cosmic-pi-deprecated/uTelescope/README.md

# uTelescope
A new mini detector developed during the GTI SDG summer school 2017
