cosmic-pi-deprecated/uTelescope/CosmicPiuTelescopeSchematic.pdf

# LM358DR-SOIC8 22uf

## +5V+³V3

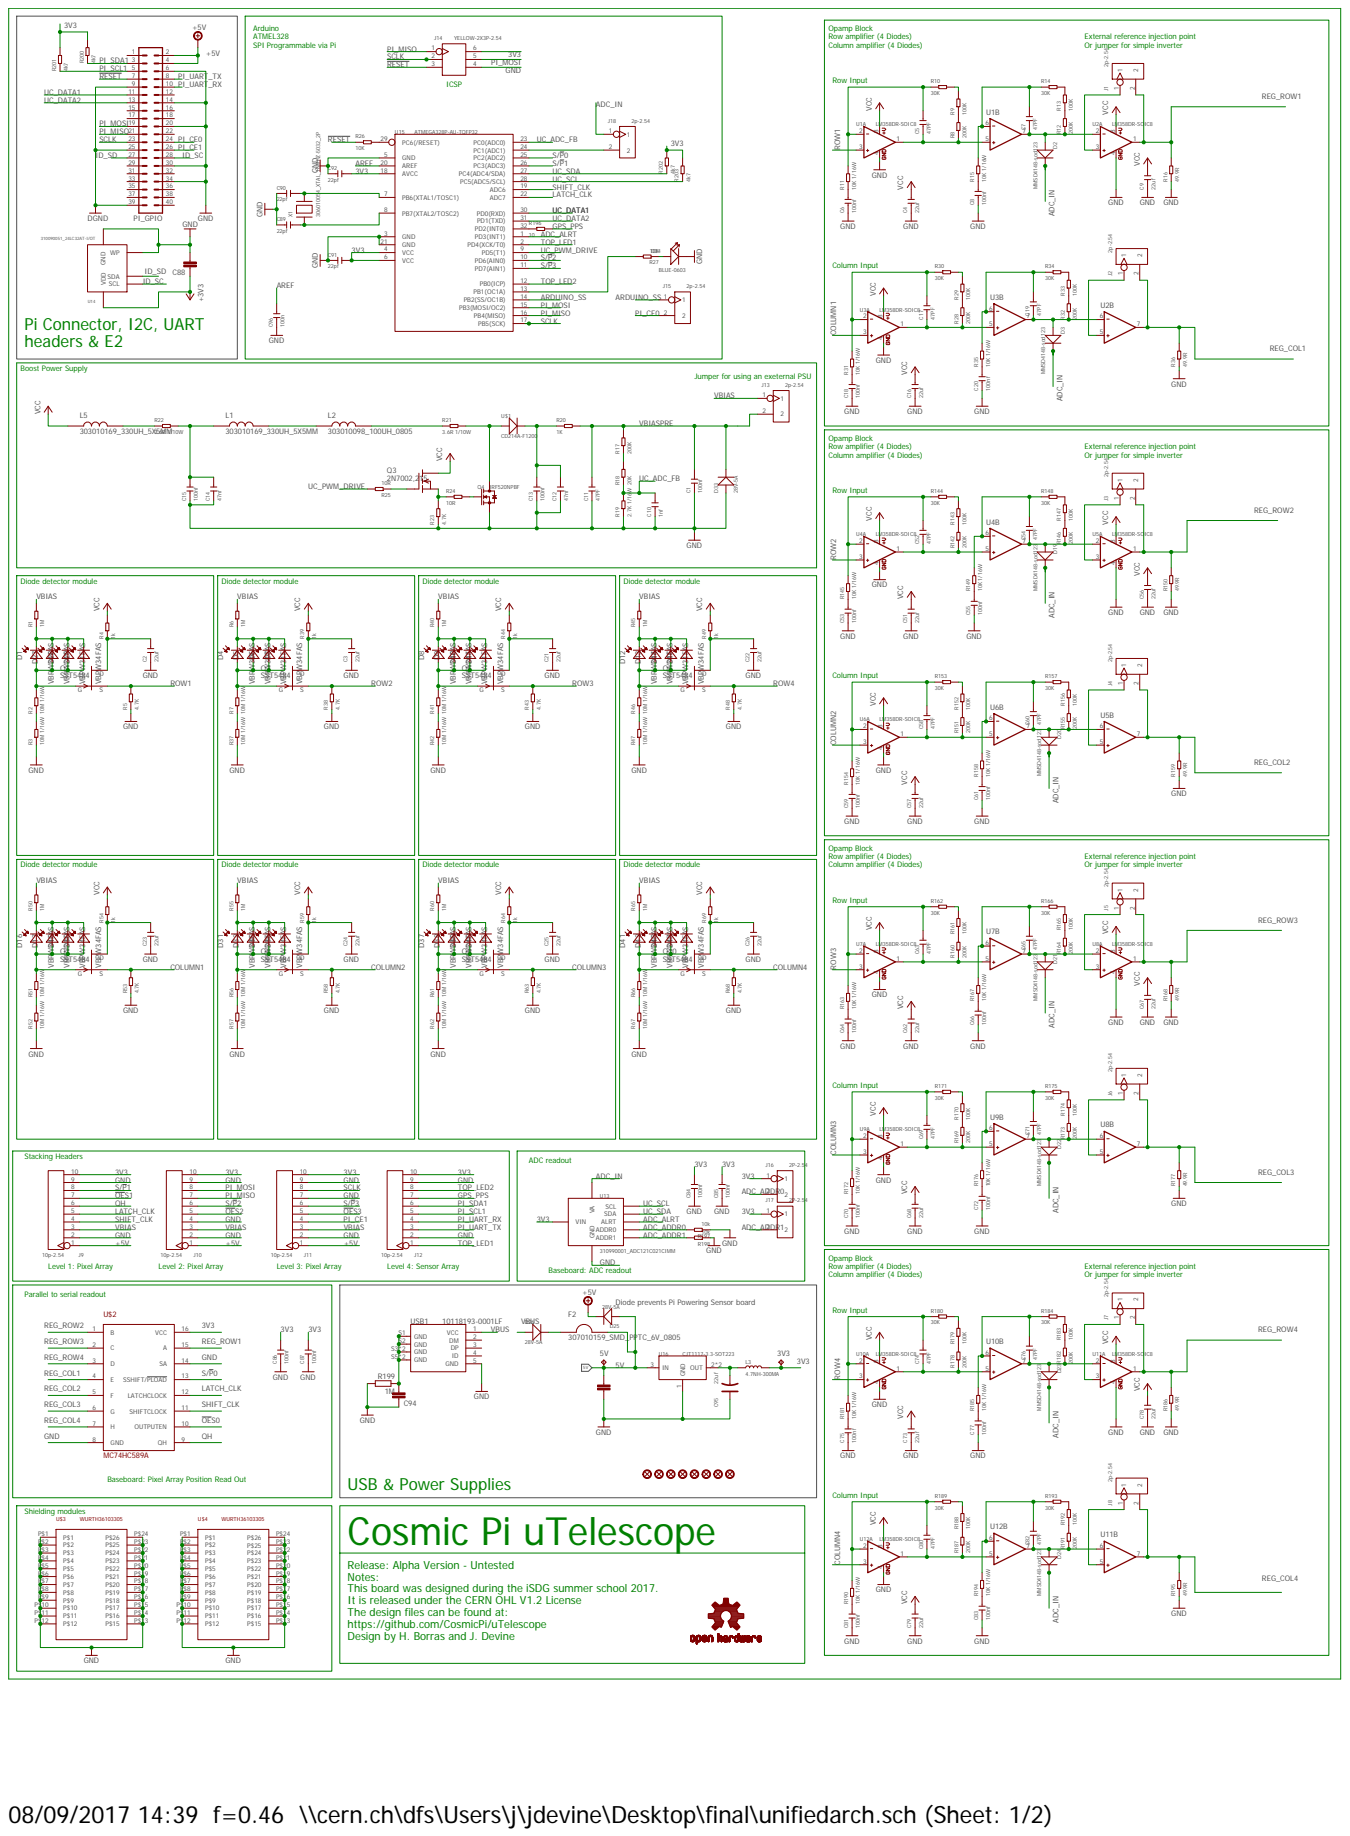
[picture p1: page 1]

External reference injection point
Or jumper for simple inverter

Jumper for using an exeternal PSU

Parallel to serial readout

Diode prevents Pi Powering Sensor board

Baseboard: Pixel Array Position Read Out

Release: Alpha Version - Untested
Notes:
This board was designed during the iSDG summer school 2017.
It is released under the CERN OHL V1.2 License
The design files can be found at:
https://github.com/CosmicPi/uTelescope
Design by H. Borras and J. Devine

08/09/2017 14:39 f=0.46 \\cern.ch\dfs\Users\j\jdevine\Desktop\final\unifiedarch.sch (Sheet: 1/2)
