cosmic-pi-deprecated/uTelescope/CosmicPiuTelescopeAlpha.brd

## EAGLE design CosmicPiuTelescopeAlpha.brd (2017-09-08)

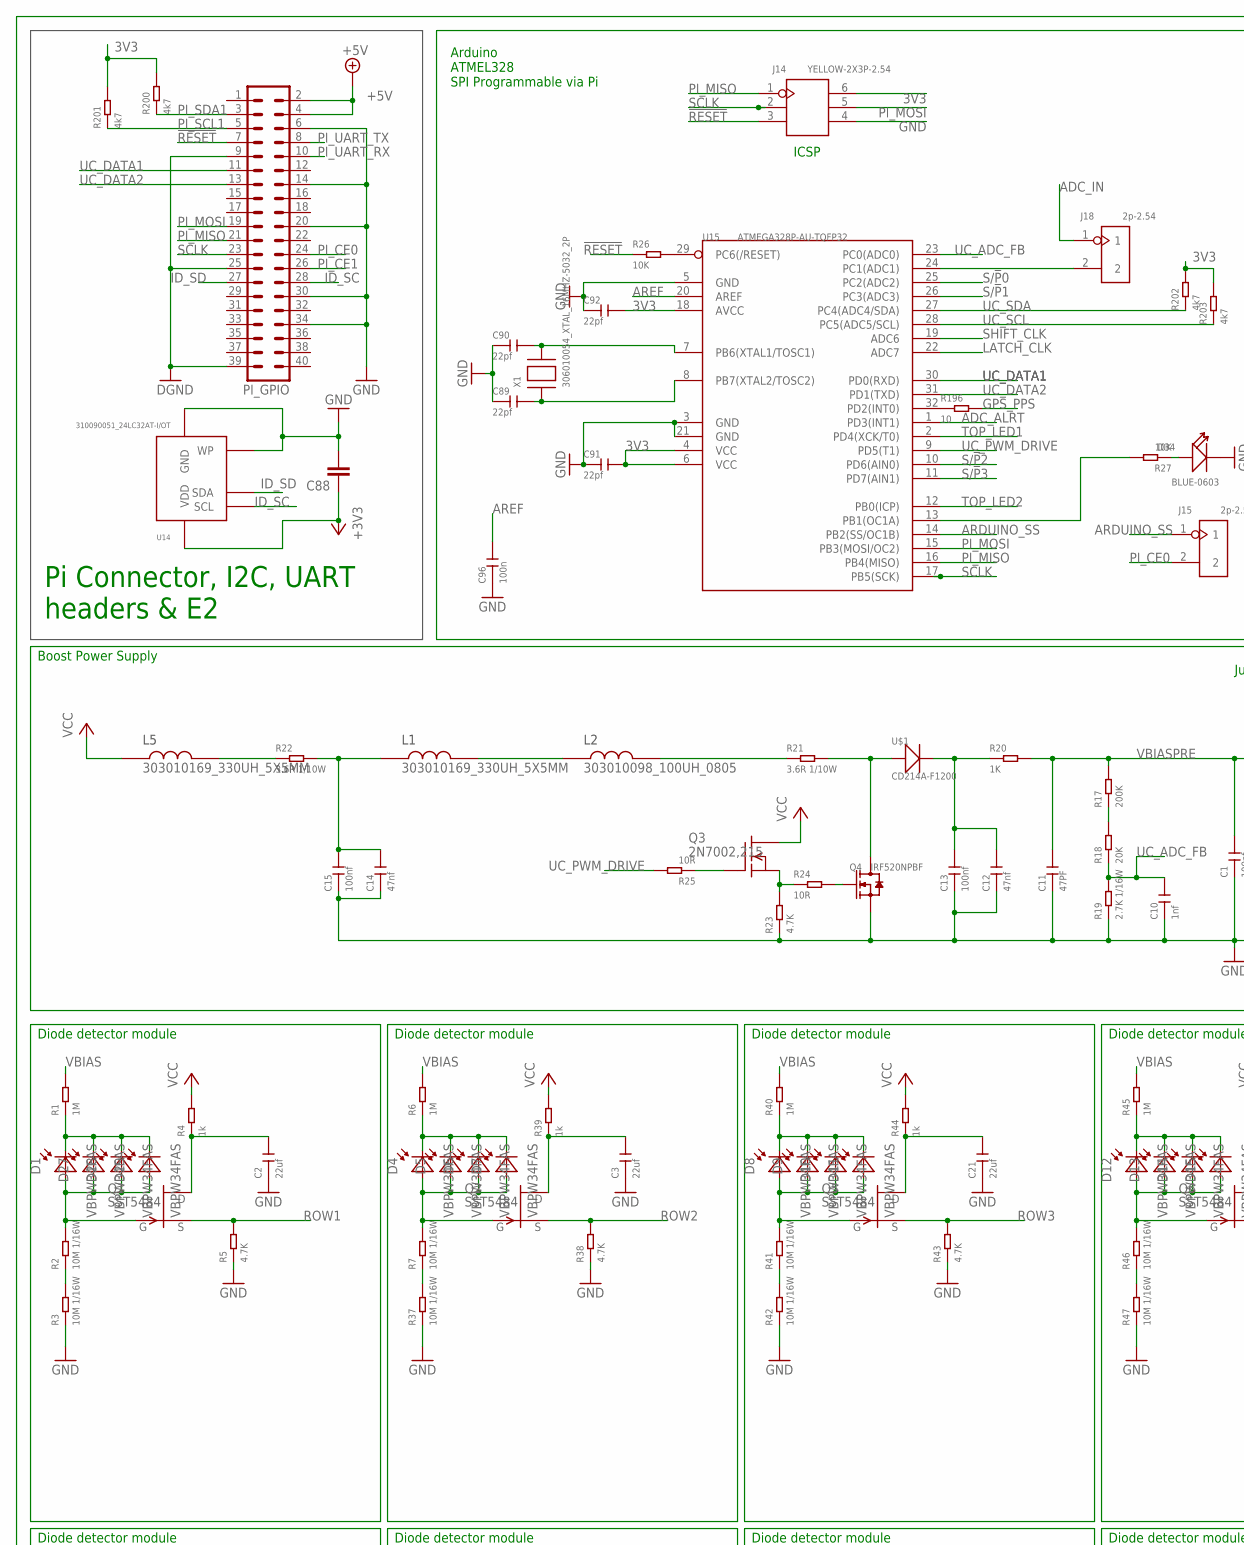
[picture p2: schematic CosmicPiuTelescopeAlpha.sch, sheet 1, part in row 1, column 1]

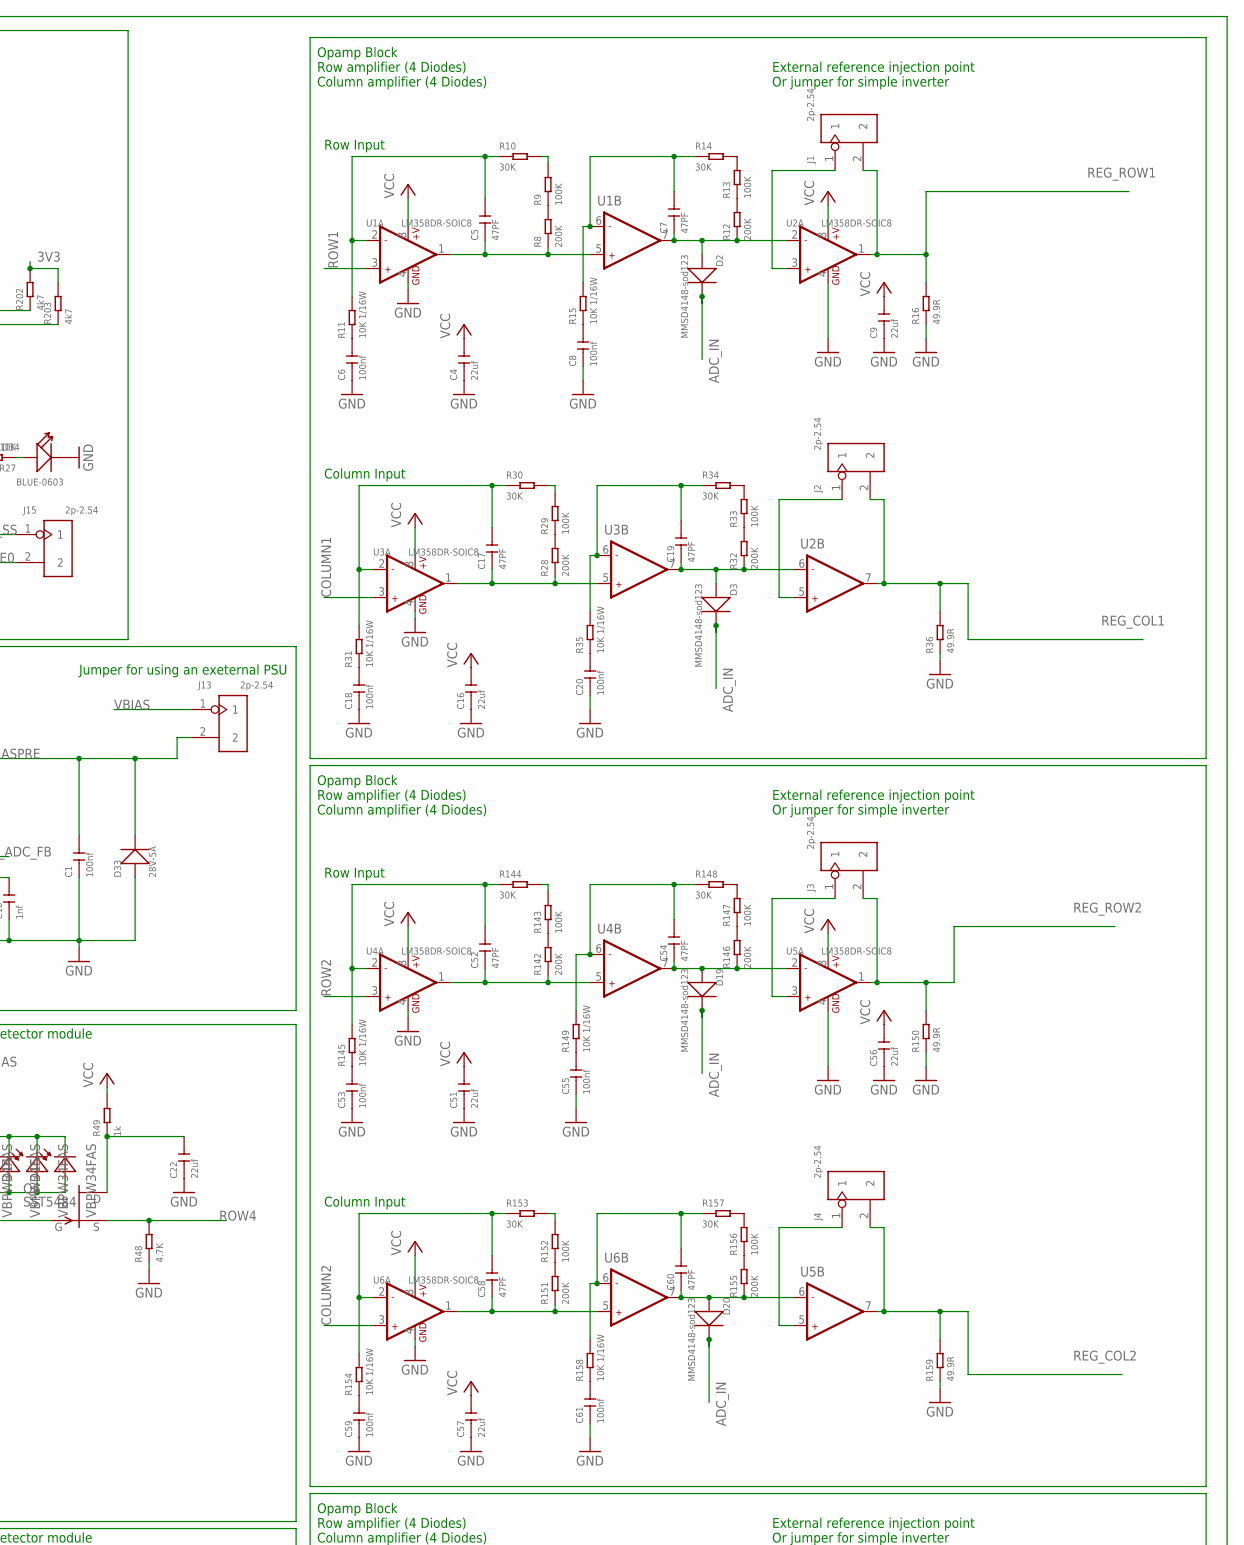
[picture p3: schematic CosmicPiuTelescopeAlpha.sch, sheet 1, part in row 1, column 2]

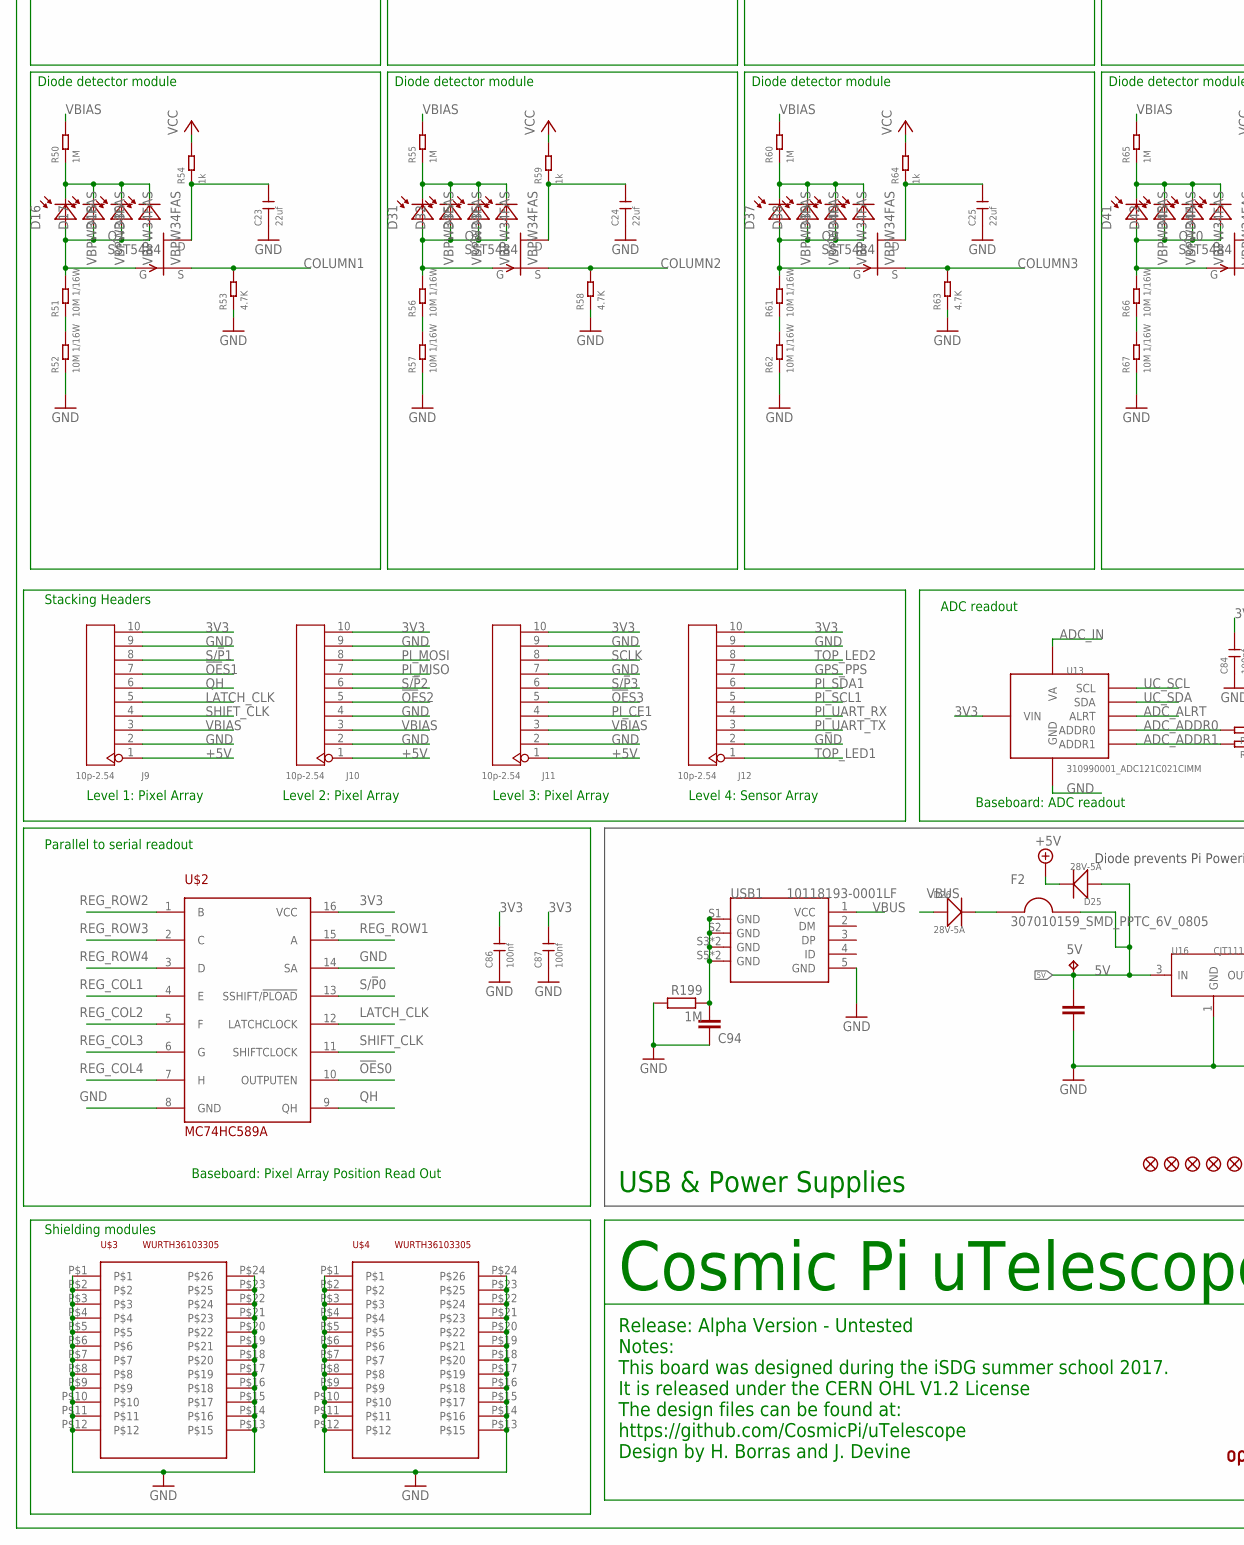
[picture p4: schematic CosmicPiuTelescopeAlpha.sch, sheet 1, part in row 2, column 1]

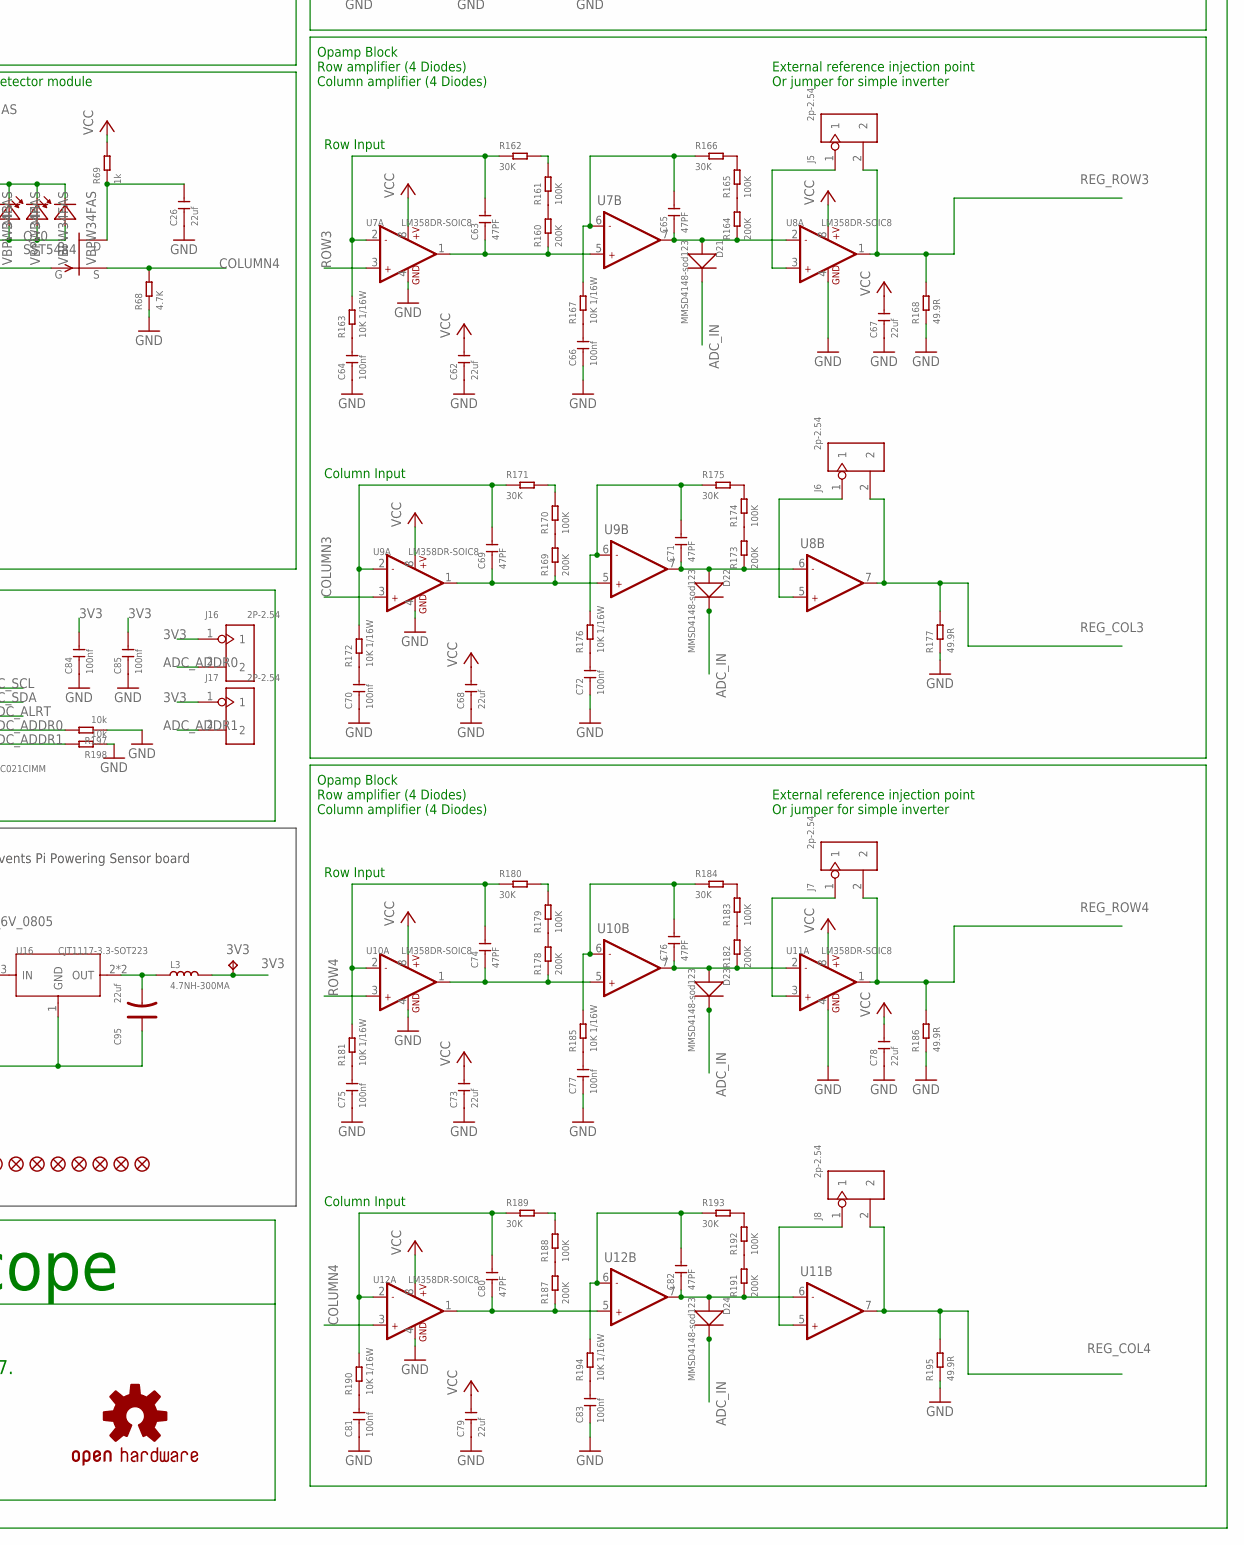
[picture p5: schematic CosmicPiuTelescopeAlpha.sch, sheet 1, part in row 2, column 2]

Parts:
3V3, 5V: TPB1,27; B1,27
C1, C13, C15: 100nf; C0603
C2, C3, C21, C22, C23, C24, C25, C26: 22uf; C1206
C4, C9, C16, C51, C56, C57, C62, C67, C68, C73, C78, C79: 22uf; C0805
C5, C7, C11, C17, C19, C52, C54, C58, C60, C63, C65, C69, C71, C74, C76, C80, C82: 47PF; C0402
C6, C8, C18, C20, C53, C55, C59, C61, C64, C66, C70, C72, C75, C77, C81, C83: 100nf; C0402
C10: 1nf; C0603
C12, C14: 47nf; C0402
C84, C85, C86, C87: 100nf; C1206
C88, C94: C-EUC0402; C0402
C89, C90, C91, C92: 22pf; C0603
C93: 47uF; 1206
C95: 22uf; AVX-B
C96: 100n; C0603
D1, D4, D5, D6, D7, D8, D9, D10, D11, D12, D13, D14, D15, D16, D17, D18, D27, D28, D29, D30, D31, D32, D35, D36, D37, D38, D39, D40, D41, D42, D43, D44: VBPW34FAS; SOD6439X130N
D2, D3, D19, D20, D21, D22, D23, D24: MMSD4148-sod123; SOD-123
D25, D26, D33: 28V-5A; DO-214AA
D34: BLUE-0603; LED-0603
F2: 307010159_SMD_PPTC_6V_0805; F0805
FD1, FD2, FD3, FD4, FD5, FD6, FD7, FD8: FIDUCIAL1X2; FIDUCIAL-1X2
J1, J2, J3, J4, J5, J6, J7, J8, J13, J15, J18: 2p-2.54; H2-2.54
J9, J10, J11, J12: 10p-2.54; H10-2.54
J14: YELLOW-2X3P-2.54; H2X3-2.54
J16, J17: 2P-2.54; H2-2.54
L1, L5: 303010169_330UH_5X5MM; L2018
L2: 303010098_100UH_0805; L0805
L3: 4.7NH-300MA; L0402
LOGO1: OSHW-LOGOL; OSHW-LOGO-L
PI_GPIO: MA20-2
Q1, Q2, Q5, Q6, Q7, Q8, Q9, Q10: SST5484; SOT23
Q3: 2N7002,215; SOT23
Q4: IRF520NPBF; TO-220
R1, R6, R40, R45, R50, R55, R60, R65, R199: 1M; R0402
R2, R3, R7, R37, R41, R42, R46, R47, R51, R52, R56, R57, R61, R62, R66, R67: 10M 1/16W; R0402
R4, R39, R44, R49, R54, R59, R64, R69: 1k; R0402
R5, R38, R43, R48, R53, R58, R63, R68: 4.7K; R0402
R8, R12, R17, R28, R32, R142, R146, R151, R155, R160, R164, R169, R173, R178, R182, R187, R191: 200K; R0603
R9, R13, R29, R33, R143, R147, R152, R156, R161, R165, R170, R174, R179, R183, R188, R192: 100K; R0402
R10, R14, R30, R34, R144, R148, R153, R157, R162, R166, R171, R175, R180, R184, R189, R193: 30K; R0603
R11, R15, R31, R35, R145, R149, R154, R158, R163, R167, R172, R176, R181, R185, R190, R194: 10K 1/16W; R0402
R16, R36, R150, R159, R168, R177, R186, R195: 49.9R; R0402
R18: 20K; R0603
R19: 2.7K 1/16W; R0402
R20: 1K; R0603
R21, R22: 3.6R 1/10W; R0603
R23: 4.7K; R0805
R24, R25: 10R; R0603
R26, R27: 10K; R0603
R196: 10; R0603
R197, R198: 10k; R0402
R200, R201, R202, R203: 4k7; R0603
U1, U2, U3, U4, U5, U6, U7, U8, U9, U10, U11, U12: LM358DR-SOIC8; SOIC8-1.27-5X4MM
U13: 310990001_ADC121C021CIMM; VSSOP8
U14: 310090051_24LC32AT-I/OT; SOT235
U15: ATMEGA328P-AU-TQFP32; TQFP32-0.8-7X7MM
U16: CJT1117-3.3-SOT223; SOT-223
U$1: CD214A-F1200; DIOM8059X265N
U$2: MC74HC589A; SOIC127P600X175-16N
U$3, U$4: WURTH36103305; 36103305
USB1: 10118193-0001LF; MICRO-USB5+6P-SMD-0.65-B
X1: 306010054_XTAL_16MHZ-5032_2P; X5032_2P

Connections:
3V3: 3V3.TP, C84.2, C85.2, C86.2, C87.2, C88.1, C91.2, C92.2, J9.10, J10.10, J11.10, J12.10, J14.6, J16.1, J17.1, L3.2, R200.2, R201.2, R202.2, R203.2, U13.P$4 (VIN), U14.4 (VDD), U15.4 (VCC), U15.6 (VCC), U15.18 (AVCC), U$2.16 (VCC)
5V: 5V.TP, C93.1, D25.+, F2.P$2, U16.3 (IN)
!OE!S0: U$2.10 (OUTPUTEN)
!OE!S1: J9.7
!OE!S2: J10.5
!OE!S3: J11.5
!RESET: J14.3, PI_GPIO.7, R26.1
+5V: C4.2, C9.2, C16.2, C51.2, C56.2, C57.2, C62.2, C67.2, C68.2, C73.2, C78.2, C79.2, D25.-, J9.1, J10.1, J11.1, L5.P$1, PI_GPIO.2, PI_GPIO.4, Q3.3 (D), R4.2, R39.2, R44.2, R49.2, R54.2, R59.2, R64.2, R69.2, U1.8 (+V), U2.8 (+V), U3.8 (+V), U4.8 (+V), U5.8 (+V), U6.8 (+V), U7.8 (+V), U8.8 (+V), U9.8 (+V), U10.8 (+V), U11.8 (+V), U12.8 (+V)
ADC_ADDR0: J16.2, R197.2, U13.P$3 (ADDR0)
ADC_ADDR1: J17.2, R198.2, U13.P$6 (ADDR1)
ADC_ALRT: U13.P$2 (ALRT), U15.1 (PD3(INT1))
ADC_IN: D2.-, D3.-, D19.-, D20.-, D21.-, D22.-, D23.-, D24.-, J18.1, U13.P$5 (VA)
ARDUINO_SS: J15.1, U15.14 (PB2(SS/OC1B))
AREF: C96.2, U15.20 (AREF)
COLUMN1: Q7.2 (S), R53.2, U3.3 (+IN1)
COLUMN2: Q8.2 (S), R58.2, U6.3 (+IN1)
COLUMN3: Q9.2 (S), R63.2, U9.3 (+IN1)
COLUMN4: Q10.2 (S), R68.2, U12.3 (+IN1)
GND: C1.1, C2.1, C3.1, C4.1, C6.1, C8.1, C9.1, C10.1, C11.1, C12.1, C13.1, C14.1, C15.1, C16.1, C18.1, C20.1, C21.1, C22.1, C23.1, C24.1, C25.1, C26.1, C51.1, C53.1, C55.1, C56.1, C57.1, C59.1, C61.1, C62.1, C64.1, C66.1, C67.1, C68.1, C70.1, C72.1, C73.1, C75.1, C77.1, C78.1, C79.1, C81.1, C83.1, C84.1, C85.1, C86.1, C87.1, C88.2, C89.1, C90.1, C91.1, C92.1, C93.2, C94.1, C95.+, C96.1, D33.+, D34.-, J9.2, J9.9, J10.2, J10.4, J10.9, J11.2, J11.7, J11.9, J12.2, J12.9, J14.4, PI_GPIO.6, PI_GPIO.9, PI_GPIO.14, PI_GPIO.20, PI_GPIO.25, PI_GPIO.30, PI_GPIO.34, PI_GPIO.39, Q4.2 (S), Q4.HEAT (S), R3.1, R5.1, R16.1, R19.1, R23.1, R36.1, R37.1, R38.1, R42.1, R43.1, R47.1, R48.1, R52.1, R53.1, R57.1, R58.1, R62.1, R63.1, R67.1, R68.1, R150.1, R159.1, R168.1, R177.1, R186.1, R195.1, R197.1, R198.1, R199.2, U1.4 (GND), U2.4 (GND), U3.4 (GND), U4.4 (GND), U5.4 (GND), U6.4 (GND), U7.4 (GND), U8.4 (GND), U9.4 (GND), U10.4 (GND), U11.4 (GND), U12.4 (GND), U13.P$7 (GND), U14.2 (GND), U14.5 (WP), U15.3 (GND), U15.5 (GND), U15.21 (GND), U16.1 (GND), U$2.8 (GND), U$2.14 (SA), U$3.P$1, U$3.P$2, U$3.P$3, U$3.P$4, U$3.P$5, U$3.P$6, U$3.P$7, U$3.P$8, U$3.P$9, U$3.P$10, U$3.P$11, U$3.P$12, U$3.P$13, U$3.P$14, U$3.P$15, U$3.P$16, U$3.P$17, U$3.P$18, U$3.P$19, U$3.P$20, U$3.P$21, U$3.P$22, U$3.P$23, U$3.P$24, U$4.P$1, U$4.P$2, U$4.P$3, U$4.P$4, U$4.P$5, U$4.P$6, U$4.P$7, U$4.P$8, U$4.P$9, U$4.P$10, U$4.P$11, U$4.P$12, U$4.P$13, U$4.P$14, U$4.P$15, U$4.P$16, U$4.P$17, U$4.P$18, U$4.P$19, U$4.P$20, U$4.P$21, U$4.P$22, U$4.P$23, U$4.P$24, USB1.5 (GND)
GPS_PPS: J12.7, R196.2
ID_SC: PI_GPIO.28, U14.1 (SCL)
ID_SD: PI_GPIO.27, U14.3 (SDA)
LATCH_CLK: J9.5, U15.22 (ADC7), U$2.12 (LATCHCLOCK)
unnamed: Q4.3 (D), R21.2, U$1.1 (+)
unnamed: D1.C, D27.C, D28.C, D29.C, R1.1
unnamed: D1.A, D27.A, D28.A, D29.A, Q1.3 (G), R2.2
unnamed: R2.1, R3.2
unnamed: C2.2, Q1.1 (D), R4.1
unnamed: R28.2, R29.1
unnamed: C18.2, R31.1
unnamed: D4.C, D5.C, D6.C, D7.C, R6.1
unnamed: R8.2, R9.1
unnamed: C6.2, R11.1
unnamed: C5.1, R8.1, U1.1 (OUT1), U1.5 (+IN2)
unnamed: R9.2, R10.2
unnamed: C5.2, R10.1, R11.2, U1.2 (-IN1)
unnamed: R12.2, R13.1
unnamed: C8.2, R15.1
unnamed: R13.2, R14.2
unnamed: C7.2, R14.1, R15.2, U1.6 (-IN2)
unnamed: D4.A, D5.A, D6.A, D7.A, Q2.3 (G), R7.2
unnamed: R7.1, R37.2
unnamed: C7.1, D2.+, R12.1, U1.7 (OUT2), U2.2 (-IN1)
unnamed: J1.1, U2.3 (+IN1)
unnamed: R17.1, R18.2
unnamed: C14.2, C15.2, L1.P$1, R22.2
unnamed: C12.2, C13.2, R20.1, U$1.2 (-)
unnamed: L5.P$2, R22.1
unnamed: L2.P$2, R21.1
unnamed: Q3.2 (S), R23.2, R24.1
unnamed: Q3.1 (G), R25.1
unnamed: L1.P$2, L2.P$1
unnamed: Q4.1 (G), R24.2
unnamed: C17.1, R28.1, U3.1 (OUT1), U3.5 (+IN2)
unnamed: R29.2, R30.2
unnamed: C17.2, R30.1, R31.2, U3.2 (-IN1)
unnamed: R32.2, R33.1
unnamed: C20.2, R35.1
unnamed: R33.2, R34.2
unnamed: C19.2, R34.1, R35.2, U3.6 (-IN2)
unnamed: C19.1, D3.+, R32.1, U2.6 (-IN2), U3.7 (OUT2)
unnamed: C3.2, Q2.1 (D), R39.1
unnamed: J2.1, U2.5 (+IN2)
unnamed: D8.C, D9.C, D10.C, D11.C, R40.1
unnamed: D8.A, D9.A, D10.A, D11.A, Q5.3 (G), R41.2
unnamed: R41.1, R42.2
unnamed: C21.2, Q5.1 (D), R44.1
unnamed: D12.C, D13.C, D14.C, D15.C, R45.1
unnamed: D12.A, D13.A, D14.A, D15.A, Q6.3 (G), R46.2
unnamed: R46.1, R47.2
unnamed: C22.2, Q6.1 (D), R49.1
unnamed: D16.C, D17.C, D18.C, D30.C, R50.1
unnamed: D16.A, D17.A, D18.A, D30.A, Q7.3 (G), R51.2
unnamed: R51.1, R52.2
unnamed: C23.2, Q7.1 (D), R54.1
unnamed: D31.C, D32.C, D35.C, D36.C, R55.1
unnamed: D31.A, D32.A, D35.A, D36.A, Q8.3 (G), R56.2
unnamed: R56.1, R57.2
unnamed: C24.2, Q8.1 (D), R59.1
unnamed: D37.C, D38.C, D39.C, D40.C, R60.1
unnamed: D37.A, D38.A, D39.A, D40.A, Q9.3 (G), R61.2
unnamed: R61.1, R62.2
unnamed: C25.2, Q9.1 (D), R64.1
unnamed: D41.C, D42.C, D43.C, D44.C, R65.1
unnamed: D41.A, D42.A, D43.A, D44.A, Q10.3 (G), R66.2
unnamed: R66.1, R67.2
unnamed: C26.2, Q10.1 (D), R69.1
unnamed: R142.2, R143.1
unnamed: C53.2, R145.1
unnamed: C52.1, R142.1, U4.1 (OUT1), U4.5 (+IN2)
unnamed: R143.2, R144.2
unnamed: C52.2, R144.1, R145.2, U4.2 (-IN1)
unnamed: R146.2, R147.1
unnamed: C55.2, R149.1
unnamed: R147.2, R148.2
unnamed: C54.2, R148.1, R149.2, U4.6 (-IN2)
unnamed: C54.1, D19.+, R146.1, U4.7 (OUT2), U5.2 (-IN1)
unnamed: J3.1, U5.3 (+IN1)
unnamed: R151.2, R152.1
unnamed: C59.2, R154.1
unnamed: C58.1, R151.1, U6.1 (OUT1), U6.5 (+IN2)
unnamed: R152.2, R153.2
unnamed: C58.2, R153.1, R154.2, U6.2 (-IN1)
unnamed: R155.2, R156.1
unnamed: C61.2, R158.1
unnamed: R156.2, R157.2
unnamed: C60.2, R157.1, R158.2, U6.6 (-IN2)
unnamed: C60.1, D20.+, R155.1, U5.6 (-IN2), U6.7 (OUT2)
unnamed: J4.1, U5.5 (+IN2)
unnamed: C94.2, R199.1, USB1.S1 (GND), USB1.S2 (GND), USB1.S3 (GND), USB1.S4 (GND), USB1.S5 (GND), USB1.S6 (GND)
unnamed: R160.2, R161.1
unnamed: C64.2, R163.1
unnamed: C63.1, R160.1, U7.1 (OUT1), U7.5 (+IN2)
unnamed: R161.2, R162.2
unnamed: C63.2, R162.1, R163.2, U7.2 (-IN1)
unnamed: R164.2, R165.1
unnamed: C66.2, R167.1
unnamed: R165.2, R166.2
unnamed: C65.2, R166.1, R167.2, U7.6 (-IN2)
unnamed: C65.1, D21.+, R164.1, U7.7 (OUT2), U8.2 (-IN1)
unnamed: D26.-, F2.P$1
unnamed: J5.1, U8.3 (+IN1)
unnamed: R169.2, R170.1
unnamed: C70.2, R172.1
unnamed: C69.1, R169.1, U9.1 (OUT1), U9.5 (+IN2)
unnamed: R170.2, R171.2
unnamed: C69.2, R171.1, R172.2, U9.2 (-IN1)
unnamed: R173.2, R174.1
unnamed: C72.2, R176.1
unnamed: R174.2, R175.2
unnamed: C71.2, R175.1, R176.2, U9.6 (-IN2)
unnamed: C71.1, D22.+, R173.1, U8.6 (-IN2), U9.7 (OUT2)
unnamed: J6.1, U8.5 (+IN2)
unnamed: C95.-, L3.1, U16.2 (OUT), U16.TER (OUT)
unnamed: R178.2, R179.1
unnamed: C75.2, R181.1
unnamed: C74.1, R178.1, U10.1 (OUT1), U10.5 (+IN2)
unnamed: R179.2, R180.2
unnamed: C74.2, R180.1, R181.2, U10.2 (-IN1)
unnamed: R182.2, R183.1
unnamed: C77.2, R185.1
unnamed: R183.2, R184.2
unnamed: C76.2, R184.1, R185.2, U10.6 (-IN2)
unnamed: C76.1, D23.+, R182.1, U10.7 (OUT2), U11.2 (-IN1)
unnamed: R27.2, U15.13 (PB1(OC1A))
unnamed: J7.1, U11.3 (+IN1)
unnamed: R187.2, R188.1
unnamed: C81.2, R190.1
unnamed: C80.1, R187.1, U12.1 (OUT1), U12.5 (+IN2)
unnamed: R188.2, R189.2
unnamed: C80.2, R189.1, R190.2, U12.2 (-IN1)
unnamed: R191.2, R192.1
unnamed: C83.2, R194.1
unnamed: R192.2, R193.2
unnamed: C82.2, R193.1, R194.2, U12.6 (-IN2)
unnamed: C82.1, D24.+, R191.1, U11.6 (-IN2), U12.7 (OUT2)
unnamed: J8.1, U11.5 (+IN2)
unnamed: J18.2, U15.24 (PC1(ADC1))
unnamed: R26.2, U15.29 (PC6(/RESET))
unnamed: D34.+, R27.1
unnamed: C90.2, U15.7 (PB6(XTAL1/TOSC1)), X1.P$2
unnamed: C89.2, U15.8 (PB7(XTAL2/TOSC2)), X1.P$1
unnamed: R196.1, U15.32 (PD2(INT0))
PI_CE0: J15.2, PI_GPIO.24
PI_CE1: J11.4, PI_GPIO.26
PI_MISO: J10.7, J14.1, PI_GPIO.21, U15.16 (PB4(MISO))
PI_MOSI: J10.8, J14.5, PI_GPIO.19, U15.15 (PB3(MOSI/OC2))
PI_SCL1: J12.5, PI_GPIO.5, R201.1
PI_SDA1: J12.6, PI_GPIO.3, R200.1
PI_UART_RX: J12.4, PI_GPIO.10
PI_UART_TX: J12.3, PI_GPIO.8
QH: J9.6, U$2.9 (QH)
REG_COL1: J2.2, R36.2, U2.7 (OUT2), U$2.4 (E)
REG_COL2: J4.2, R159.2, U5.7 (OUT2), U$2.5 (F)
REG_COL3: J6.2, R177.2, U8.7 (OUT2), U$2.6 (G)
REG_COL4: J8.2, R195.2, U11.7 (OUT2), U$2.7 (H)
REG_ROW1: J1.2, R16.2, U2.1 (OUT1), U$2.15 (A)
REG_ROW2: J3.2, R150.2, U5.1 (OUT1), U$2.1 (B)
REG_ROW3: J5.2, R168.2, U8.1 (OUT1), U$2.2 (C)
REG_ROW4: J7.2, R186.2, U11.1 (OUT1), U$2.3 (D)
ROW1: Q1.2 (S), R5.2, U1.3 (+IN1)
ROW2: Q2.2 (S), R38.2, U4.3 (+IN1)
ROW3: Q5.2 (S), R43.2, U7.3 (+IN1)
ROW4: Q6.2 (S), R48.2, U10.3 (+IN1)
S/!P!0: U15.25 (PC2(ADC2)), U$2.13 (SSHIFT/!PLOAD)
S/!P!1: J9.8, U15.26 (PC3(ADC3))
S/!P!2: J10.6, U15.10 (PD6(AIN0))
S/!P!3: J11.6, U15.11 (PD7(AIN1))
SCLK: J11.8, J14.2, PI_GPIO.23, U15.17 (PB5(SCK))
SHIFT_CLK: J9.4, U15.19 (ADC6), U$2.11 (SHIFTCLOCK)
TOP_LED1: J12.1, U15.2 (PD4(XCK/T0))
TOP_LED2: J12.8, U15.12 (PB0(ICP))
UC_ADC_FB: C10.2, R18.1, R19.2, U15.23 (PC0(ADC0))
UC_DATA1: PI_GPIO.11, U15.30 (PD0(RXD))
UC_DATA2: PI_GPIO.13, U15.31 (PD1(TXD))
UC_PWM_DRIVE: R25.2, U15.9 (PD5(T1))
UC_SCL: R203.1, U13.P$1 (SCL), U15.28 (PC5(ADC5/SCL))
UC_SDA: R202.1, U13.P$8 (SDA), U15.27 (PC4(ADC4/SDA))
VBIAS: J9.3, J10.3, J11.3, J13.1, R1.2, R6.2, R40.2, R45.2, R50.2, R55.2, R60.2, R65.2
VBIASPRE: C1.2, C11.2, D33.-, J13.2, R17.2, R20.2
VBUS: D26.+, USB1.1 (VCC)

Notes on the sheet:
External reference injection point Or jumper for simple inverter
Boost Power Supply
Diode detector module
Opamp Block Row amplifier (4 Diodes) Column amplifier (4 Diodes)
Row Input
Column Input
Stacking Headers
Level 1: Pixel Array
Level 2: Pixel Array
Level 3: Pixel Array
Level 4: Sensor Array
Parallel to serial readout
Baseboard: Pixel Array Position Read Out
ADC readout
Baseboard: ADC readout
Jumper for using an exeternal PSU
Pi Connector, I2C, UART headers & E2
Diode prevents Pi Powering Sensor board
USB & Power Supplies
Arduino ATMEL328 SPI Programmable via Pi
ICSP
Shielding modules
Cosmic Pi uTelescope
Release: Alpha Version - Untested Notes: This board was designed during the iSDG summer school 2017. It is released under the CERN OHL V1.2 License The design files can be found at: https://github.com/CosmicPi/uTelescope Design by H. Borras and J. Devine

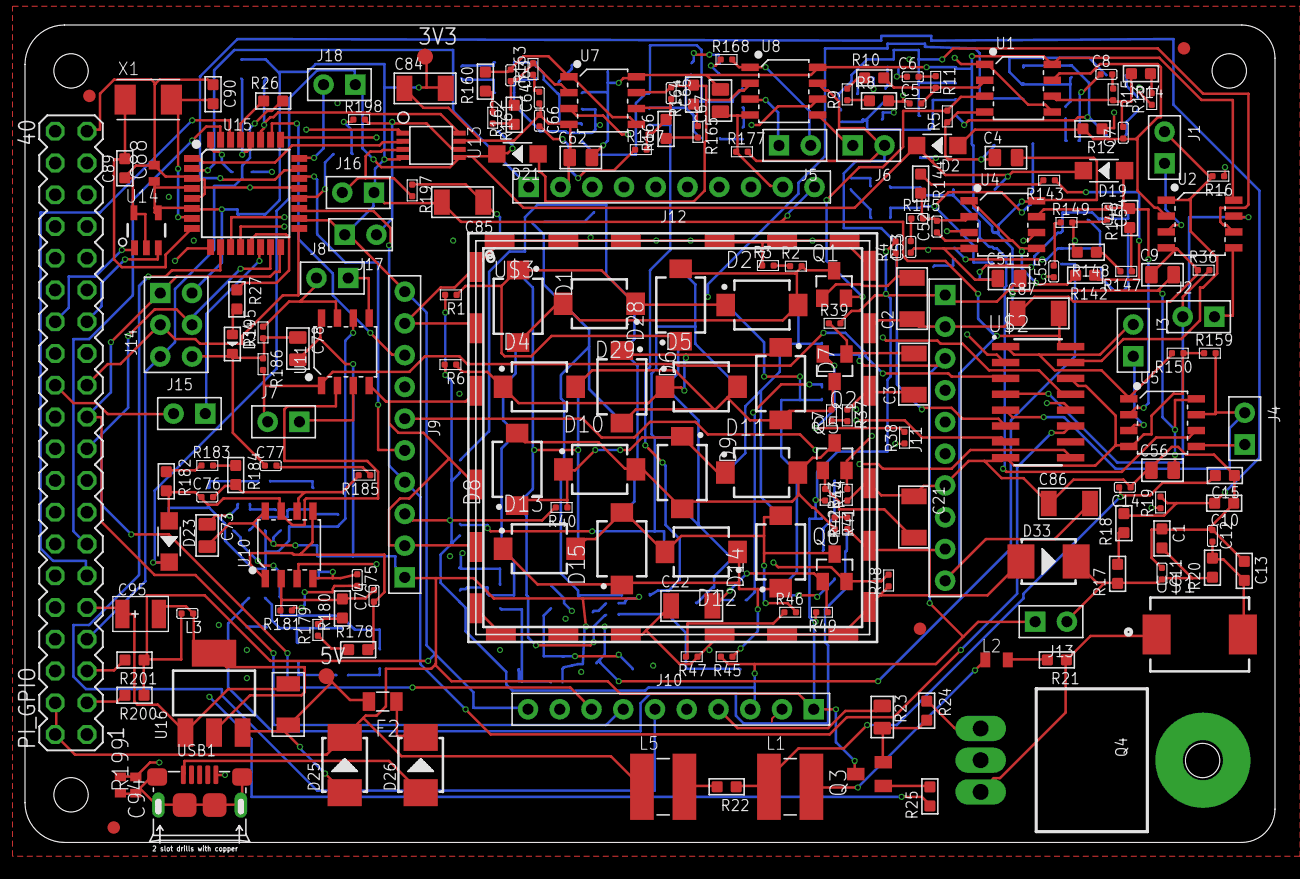
[picture p6: board CosmicPiuTelescopeAlpha.brd from above]

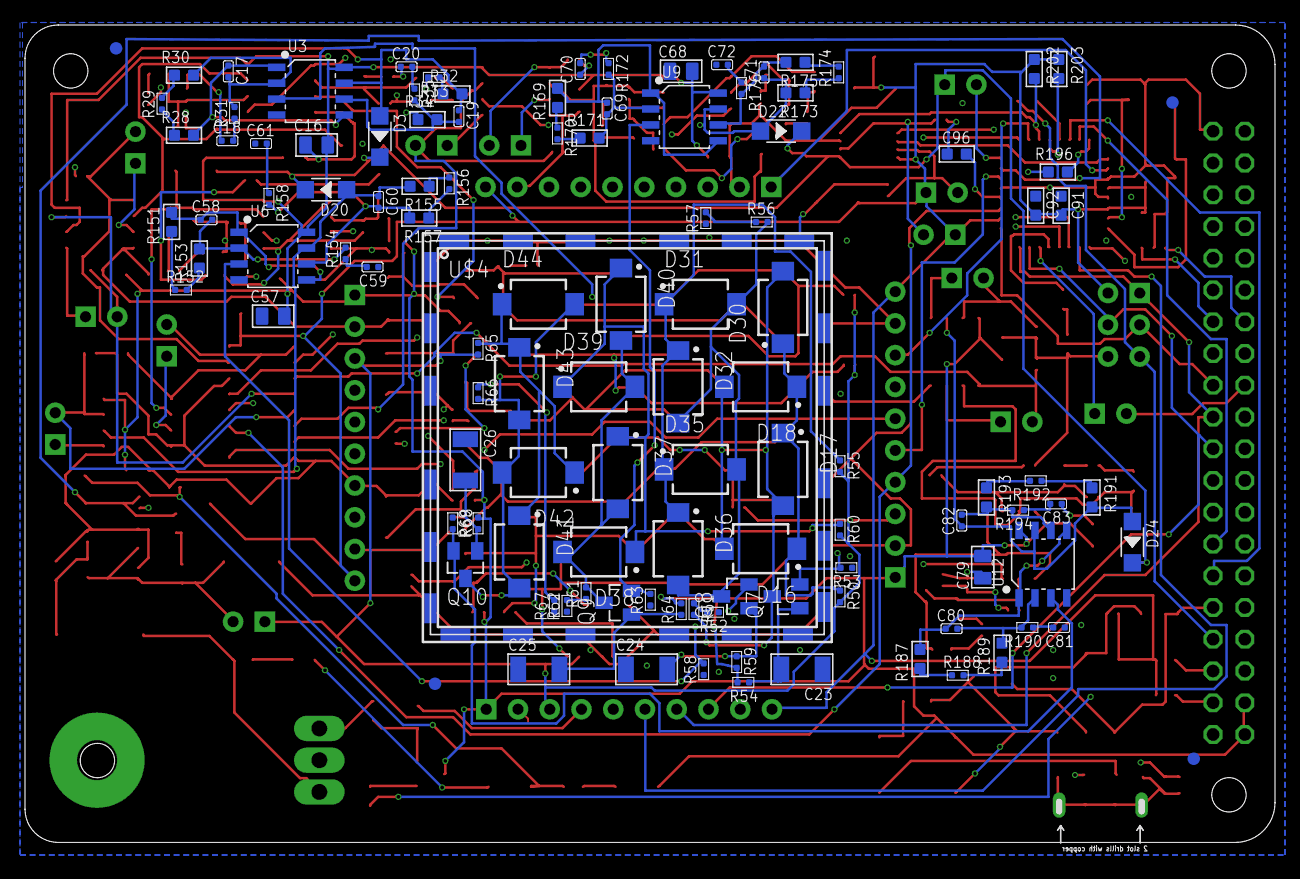
[picture p7: board CosmicPiuTelescopeAlpha.brd from below]

Board: 4 copper layers, 100.0 x 65.4 mm, 314 parts (115 on the bottom side), 197 nets.
