cosmic-pi-deprecated/uTelescope/(commit log)

2017-09-08 First upload.
    Hardware is currently being produced, so far it's 100% untested!
    [CosmicPiuTelescopeAlpha.brd, CosmicPiuTelescopeAlpha.sch]
2017-09-08 BOM for prototype production via SEEED
    [BOM_for_unified_arch_for_Seeed.csv]
2018-01-08 4k7 part swapped for 1k on R4,R39,R44,R49,R54,R59,R64,R69
    This was a mistake in the BOM, the schematic is correct.
    [BOM_for_unified_arch_for_Seeed.csv]
