cosmic-pi-deprecated/uTelescope/(notices)

Notices in the files:
CosmicPiuTelescopeAlpha.brd:
Licensed under CERN OHL V1.2
parts and their libraries:
SparkFun-Aesthetics: Licensing: Creative Commons ShareAlike 4.0 International - https://creativecommons.org/licenses/by-sa/4.0
